selimkeles/DC_Bus/DCBus.kicad_pcb

## KiCad design DCBus.kicad_pcb (2026-11-09)

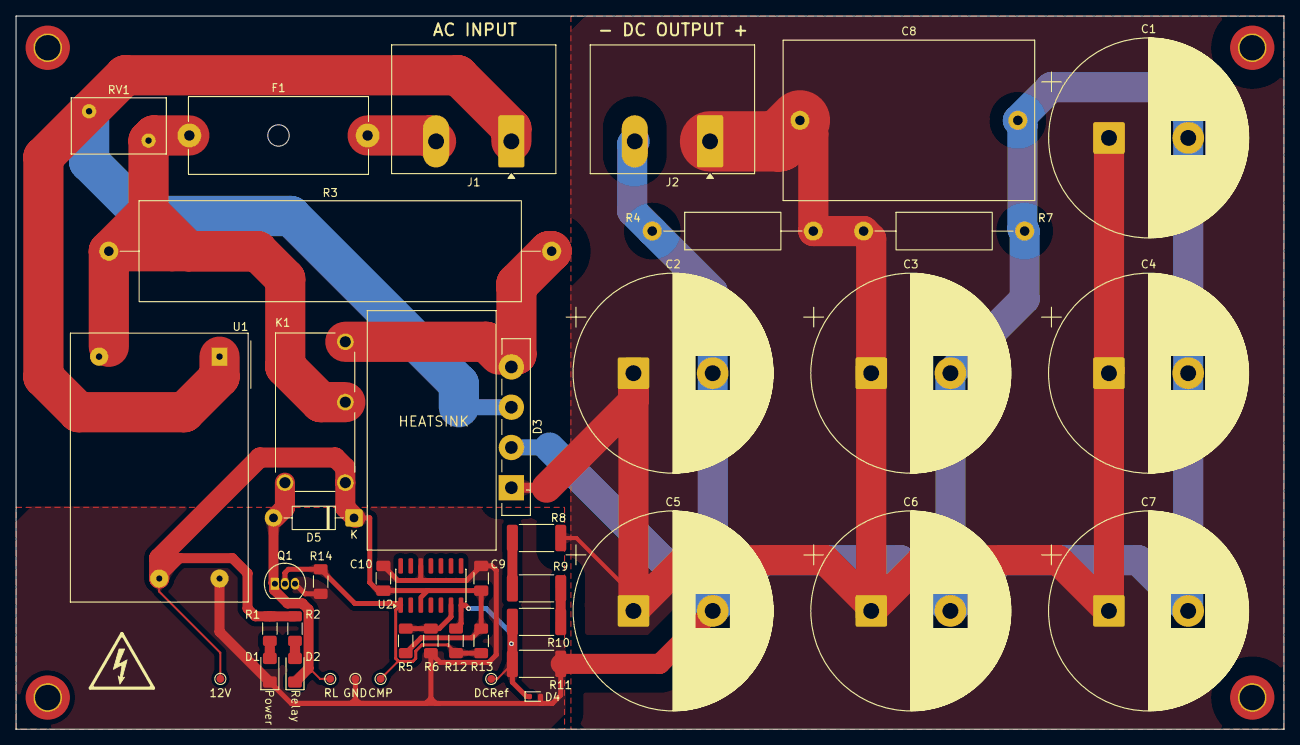
[picture p3: board DCBus.kicad_pcb from above]

Board: 2 copper layers, 160.0 x 90.0 mm, 42 parts (0 on the bottom side), 15 nets.

Parts:
12V: TestPoint; TestPoint_Pad_D1.0mm
C1, C2, C3, C4, C5, C6, C7: 470u; CP_Radial_D25.0mm_P10.00mm_SnapIn
C8: 10u; C_Rect_L31.5mm_W20.0mm_P27.50mm_MKS4
C9: 100n; C_1206_3216Metric_Pad1.33x1.80mm_HandSolder
C10: 10uF; C_1206_3216Metric_Pad1.33x1.80mm_HandSolder
CMP: TestPoint; TestPoint_Pad_D1.0mm
D1, D2: LED; LED_1206_3216Metric_Pad1.42x1.75mm_HandSolder
D3: GBU3510; Diode_Bridge_Vishay_GBU
D4: 9.1V; D_SOD-523
D5: 1N4007; D_DO-41_SOD81_P10.16mm_Horizontal
DCRef: TestPoint; TestPoint_Pad_D1.0mm
F1: 10A Fuse; Fuseholder_Cylinder-5x20mm_Schurter_0031_8201_Horizontal_Op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
GND: TestPoint; TestPoint_Pad_D1.0mm
J1: AC_IN_TERM; TerminalBlock_Ningbo-Kagnex_HB9500M_1x02_P9.5mm
J2: DC_OUT_TERM; TerminalBlock_Ningbo-Kagnex_HB9500M_1x02_P9.5mm
K1: ALQ312; RELAY_ALQ312
Q1: BC547; TO-92_Inline
R1, R2: 1K; R_1206_3216Metric_Pad1.30x1.75mm_HandSolder
R3: 100R 10W; R_Axial_Power_L48.0mm_W12.5mm_P55.88mm
R4, R7: 100K; R_Axial_DIN0414_L11.9mm_D4.5mm_P20.32mm_Horizontal
R5, R6: 33K; R_1206_3216Metric_Pad1.30x1.75mm_HandSolder
R8, R9: 270K; R_2512_6332Metric_Pad1.40x3.35mm_HandSolder
R10: 20K; R_2512_6332Metric_Pad1.40x3.35mm_HandSolder
R11: 12K; R_2512_6332Metric_Pad1.40x3.35mm_HandSolder
R12: 120K; R_1206_3216Metric_Pad1.30x1.75mm_HandSolder
R13, R14: 10K; R_1206_3216Metric_Pad1.30x1.75mm_HandSolder
RL: TestPoint; TestPoint_Pad_D1.0mm
RV1: Varistor 275VAC; RV_Disc_D12mm_W7.1mm_P7.5mm
U1: IRM-02-12; Converter_ACDC_MeanWell_IRM-02-xx_THT
U2: LM339; SOIC-14_3.9x8.7mm_P1.27mm

Connections:
+12V: 12V.1 (1_1), C9.1, C10.1, D5.1 (K), K1.C1, R1.1, R2.1, R5.2, R13.2, U1.4 (+Vo), U2.3 (V+)
+VDC: C1.1, C2.1, C3.1, C4.1, C5.1, C6.1, C7.1, C8.1, D3.1 (+), J2.1, R4.2, R7.1, R8.2
/Bus_Ref: D4.1 (K), DCRef.1 (1_1), R10.1, R11.2, R12.2, U2.7 (+)
/Comp_Output: CMP.1 (1_1), Q1.2 (B), R12.1, R13.1, R14.2, U2.1
/LINE_F: F1.1, K1.COM, R3.1, RV1.1, U1.2 (AC/L)
/LINE_SW: D3.4, K1.NO, R3.2
/Relay Status: D2.1 (K), D5.2 (A), K1.C2, Q1.1 (C), RL.1 (1_1)
GND: C1.2, C2.2, C3.2, C4.2, C5.2, C6.2, C7.2, C8.2, C9.2, C10.2, D1.1 (K), D3.2 (-), D4.2 (A), GND.1 (1_1), J2.2, Q1.3 (E), R4.1, R6.1, R7.2, R11.1, R14.1, U1.3 (-Vo), U2.12 (V-)
LINE: F1.2, J1.2
NEUT: D3.3, J1.1, RV1.2, U1.1 (AC/N)
unnamed: D1.2 (A), R1.2
unnamed: D2.2 (A), R2.2
unnamed: R8.1, R9.2
unnamed: R9.1, R10.2
unnamed: R5.1, R6.2, U2.6 (-)
