selimkeles/DC_Bus/(commit log)

2026-11-03 removed unnecessary files
    [VoltageDivider.ods, freerouting.dsn, temp-freerouting.dsn]
2026-11-05 new orientation for PCB for DRC Checks
    [DCBus.kicad_pcb, DCBus.kicad_sch]
2026-11-09 Revision 1
    [DCBus.kicad_pcb, DCBus.kicad_sch]
2026-11-09 Bom added
